aeldar/biggus-darkus/firmware/README.md

# Biggus Darkus — Firmware

Arduino firmware for the Biggus Darkus project.

- Sketch: [`BiggusDarkus/BiggusDarkus.ino`](BiggusDarkus/BiggusDarkus.ino) — open this folder in the Arduino IDE.
- Wiring: [`docs/hardware.md`](docs/hardware.md) — pin numbers live in [`BiggusDarkus/pins.h`](BiggusDarkus/pins.h).
- Architecture: [`docs/architecture.md`](docs/architecture.md) — modes and module layout.
- Serial commands: [`docs/commands.md`](docs/commands.md) — console protocol and command reference.

## License

MIT — see [LICENSE](LICENSE).
