aeldar/biggus-darkus/pcb/biggus-darkus-pcb.kicad_pcb

## KiCad design pcb/biggus-darkus-pcb.kicad_pcb (2026-11-14)

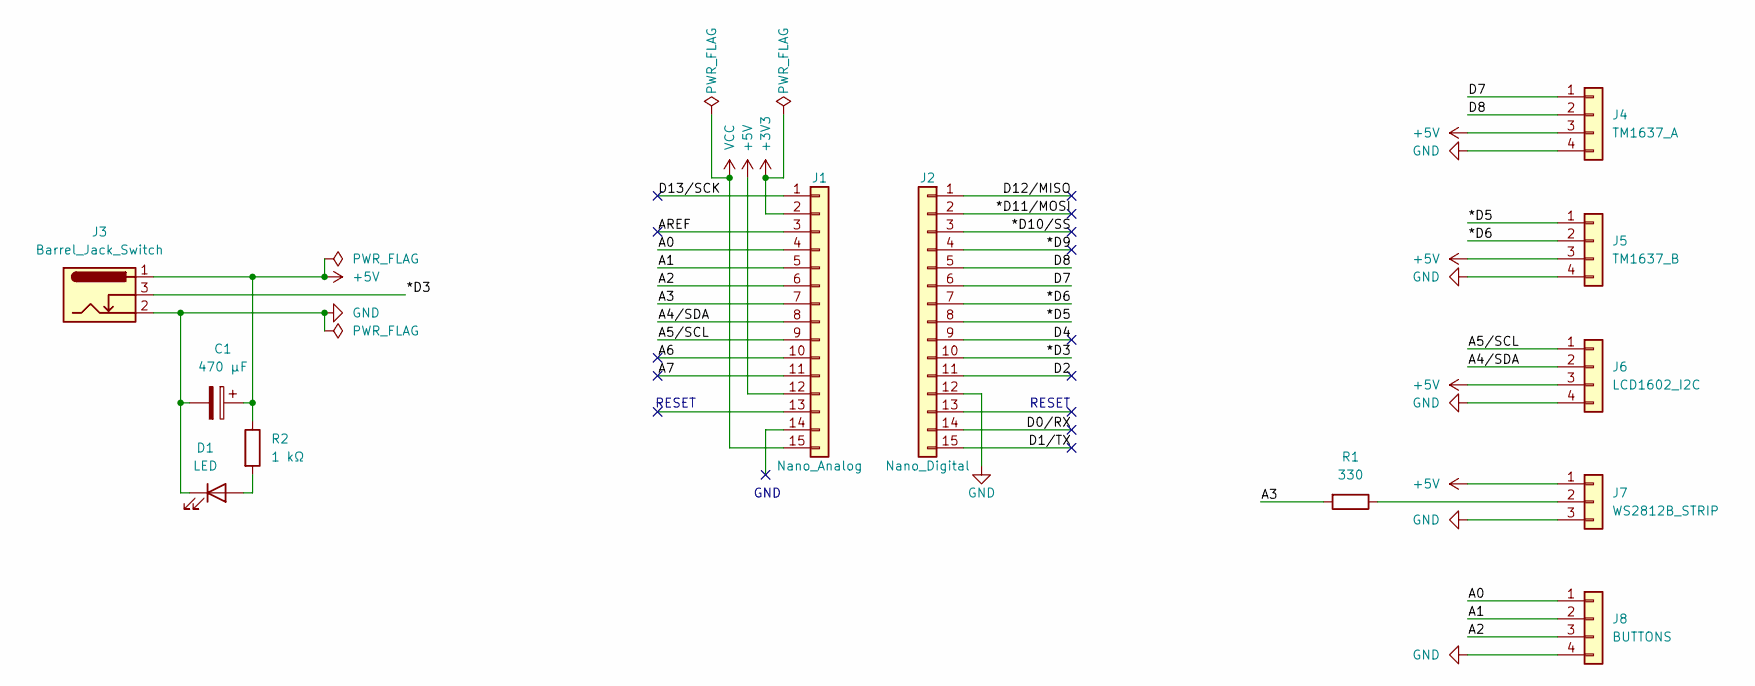
[picture p1: schematic biggus-darkus-pcb.kicad_sch, Biggus Darkus]

Parts:
C1: 470 µF; CP_Radial_D6.3mm_P2.50mm
D1: LED; LED_D5.0mm
J1: Nano_Analog; PinSocket_1x15_P2.54mm_Vertical
J2: Nano_Digital; PinSocket_1x15_P2.54mm_Vertical
J3: Barrel_Jack_Switch; BarrelJack_Horizontal
J4: TM1637_A; JST_XH_S4B-XH-A_1x04_P2.50mm_Horizontal
J5: TM1637_B; JST_XH_S4B-XH-A_1x04_P2.50mm_Horizontal
J6: LCD1602_I2C; JST_XH_S4B-XH-A_1x04_P2.50mm_Horizontal
J7: WS2812B_STRIP; JST_XH_S3B-XH-A_1x03_P2.50mm_Horizontal
J8: BUTTONS; JST_XH_S4B-XH-A_1x04_P2.50mm_Horizontal
R1: 330; R_Axial_DIN0207_L6.3mm_D2.5mm_P10.16mm_Horizontal
R2: 1 kΩ; R_Axial_DIN0207_L6.3mm_D2.5mm_P10.16mm_Horizontal

Connections:
+3V3: J1.2
+5V: C1.1, J1.12, J3.1, J4.3, J5.3, J6.3, J7.1, R2.1
/*D3: J2.10, J3.3
/*D5: J2.8, J5.1
/*D6: J2.7, J5.2
/*D9: J2.4
/*D10/SS: J2.3
/*D11/MOSI: J2.2
/A0: J1.4, J8.1
/A1: J1.5, J8.2
/A2: J1.6, J8.3
/A3: J1.7, R1.2
/A4/SDA: J1.8, J6.2
/A5/SCL: J1.9, J6.1
/A6: J1.10
/A7: J1.11
/AREF: J1.3
/D0/RX: J2.14
/D1/TX: J2.15
/D2: J2.11
/D4: J2.9
/D7: J2.6, J4.1
/D8: J2.5, J4.2
/D12/MISO: J2.1
/D13/SCK: J1.1
GND: C1.2, D1.1 (K), J2.12, J3.2, J4.4, J5.4, J6.4, J7.3, J8.4
unnamed: D1.2 (A), R2.2
unnamed: J7.2, R1.1
VCC: J1.15

Notes on the sheet:
GND
RESET

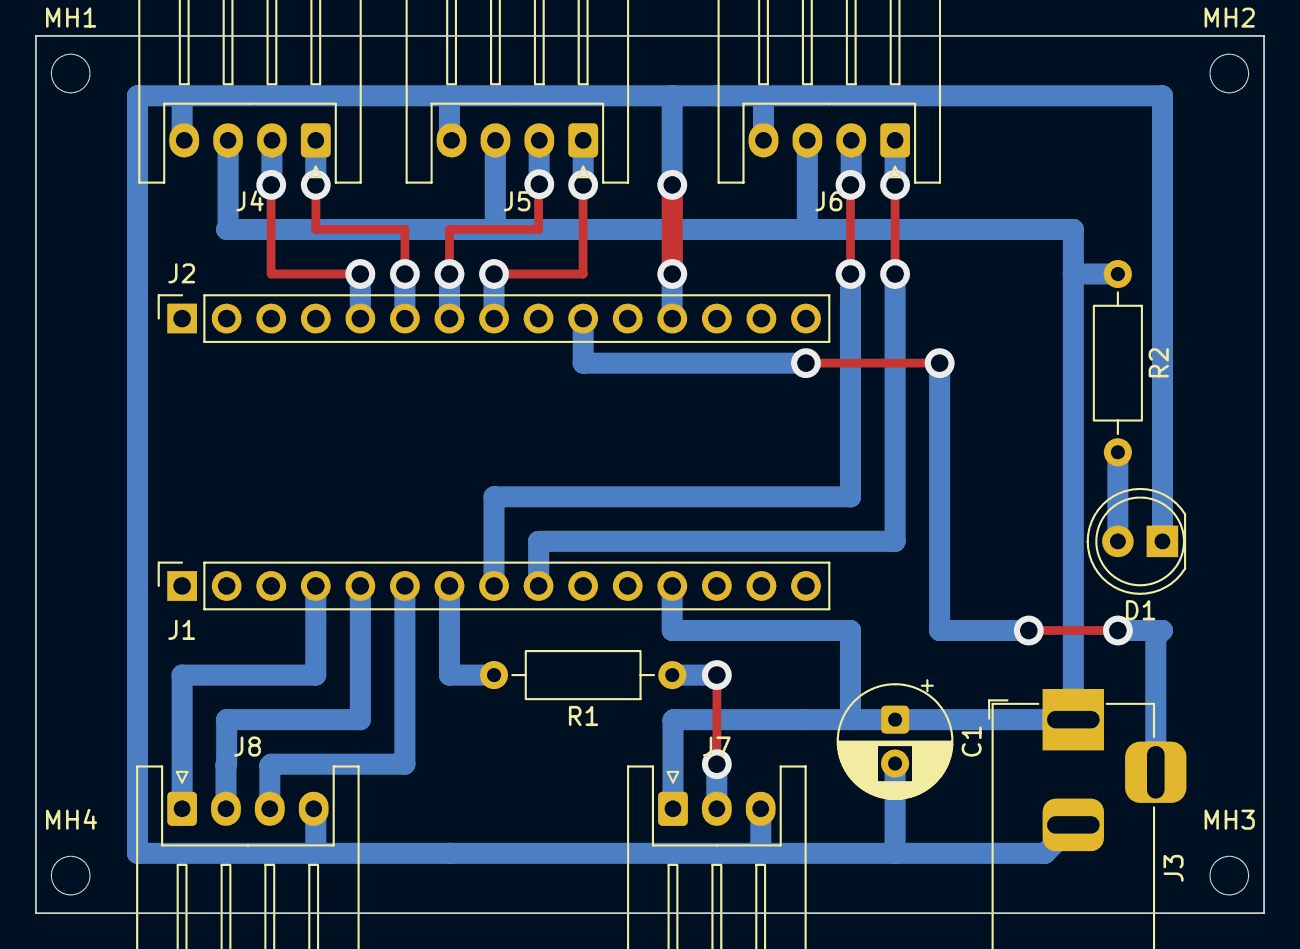
[picture p2: board biggus-darkus-pcb.kicad_pcb from above]

Board: 2 copper layers, 70.0 x 50.0 mm, 16 parts (0 on the bottom side), 15 nets.

Other parts of the board:
MH1, MH2, MH3, MH4: MountingHole_2.2mm_M2
