aeldar/biggus-darkus/(commit log)

2026-10-03 Add .gitignore for Arduino/C++ build artifacts
2026-10-20 add digit displays and lcd i2c
2026-10-20 Fix slow LED animation caused by blocking delay in digit display loop
    loopDigitDisplay() called delay(100) every iteration of the main loop,
    throttling the whole sketch (including FastLED) to ~10fps. Use millis()
    based timing instead so the digit display update doesn't block FastLED.
    [DemoReel100.ino]
2026-10-28 change pins, add current optimizations
2026-10-28 Add A0 button to toggle demo mode on and off
    When off, the LCD shows "Demo OFF" and the LED strip and TM1637 displays are blanked.
2026-10-28 Show FPS and estimated LED current on LCD row 2
2026-10-28 Move pin wiring into pins.h
2026-10-28 Document hardware wiring and pin map
2026-10-28 Note Arduino Nano as the target board
2026-10-28 Cap strip at 400 mA and mark over-cap readings on the LCD
2026-10-28 Document power supply as interchangeable
2026-10-29 Pin Nano FQBN for arduino-cli
2026-10-29 Move LCD status and button debounce into modules
2026-10-29 Add global modes and serial control
    Split hardware behaviour into app_mode, serial_commands, four_digit_display, counter_display, led_strip and status_lcd modules. Add MODE DEMO/ACTIVE/OFF, time modes, counter modes, LCD text and LED overlays. Document the architecture and command protocol.
2026-10-29 Fix clock day length overflow on 16-bit AVR int
    [four_digit_display.cpp]
2026-11-03 Make new LED range replace overlapping overlays
    Older overlays are trimmed, split or removed where the new range
    overlaps them, so stale animations no longer show through.
    [led_strip.cpp]
2026-11-03 Store LED command state per LED instead of overlay slots
    Each LED remembers its own state, so a new range overwrites old
    animations without slot limits. Adds manual overlap tests.
2026-11-07 Milestone 1: bd-protocol typed device language and generated docs
2026-11-07 Milestone 2: bd-device serial link, fake board and bd-cli send
2026-11-07 Milestone 4a: bd-rules config, priority resolver and default rules
    [config.rs, lib.rs, plan.rs, template.rs]
2026-11-07 Milestone 4b: bd-cli run joins journal, rules and device
2026-11-07 Retry MODE ACTIVE while the board boots; report why connecting failed
2026-11-07 Add pcb (KiCad design)
    [biggus-darkus-pcb.kicad_pcb, biggus-darkus-pcb.kicad_sch]
2026-11-07 Ignore KiCad per-user view state
2026-11-10 add kicad skills
2026-11-10 improve schematics
    [biggus-darkus-pcb.kicad_pcb, biggus-darkus-pcb.kicad_sch]
2026-11-10 tune the board
    [biggus-darkus-pcb.kicad_pcb]
2026-11-11 clean up schematics
    [biggus-darkus-pcb.kicad_sch]
2026-11-11 correct the schematics
    [biggus-darkus-pcb.kicad_sch]
2026-11-11 correct power pins on a barrel
    [biggus-darkus-pcb.kicad_sch]
2026-11-11 improve power
    [biggus-darkus-pcb.kicad_sch]
2026-11-11 initial design of pcb
    [biggus-darkus-pcb.kicad_pcb]
2026-11-11 add buttons to schematics
    [biggus-darkus-pcb.kicad_sch]
2026-11-11 add buttons to pcb
    [biggus-darkus-pcb.kicad_pcb]
2026-11-11 mirror pins in connectors
    [biggus-darkus-pcb.kicad_pcb, biggus-darkus-pcb.kicad_sch]
2026-11-11 add no-connection to schematics pins
    [biggus-darkus-pcb.kicad_sch]
2026-11-11 update nano pins
    [biggus-darkus-pcb.kicad_pcb, biggus-darkus-pcb.kicad_sch]
2026-11-11 use pin socket for nano, instead of pinheader
    [biggus-darkus-pcb.kicad_pcb, biggus-darkus-pcb.kicad_sch]
2026-11-11 use pin socket footprint for nano in pcb
    [biggus-darkus-pcb.kicad_pcb]
2026-11-11 update pcb;
    [biggus-darkus-pcb.kicad_pcb]
2026-11-11 align the grid
    [biggus-darkus-pcb.kicad_pcb]
2026-11-11 fix barrel postion
    [biggus-darkus-pcb.kicad_pcb]
2026-11-11 remove holes
2026-11-11 fit into a perfboard sized 23x18
    [biggus-darkus-pcb.kicad_pcb]
2026-11-13 pcb: align holes and pins according to the real perfboard
    [biggus-darkus-pcb.kicad_pcb]
2026-11-13 correct positions of components a little
    [biggus-darkus-pcb.kicad_pcb]
2026-11-13 add rails. Move led strip D4 -> A3
    [biggus-darkus-pcb.kicad_pcb, biggus-darkus-pcb.kicad_sch]
2026-11-13 add most of the baskside tracks
    [biggus-darkus-pcb.kicad_pcb]
2026-11-13 add forground connectors, fix back ones
    [biggus-darkus-pcb.kicad_pcb]
2026-11-13 fix errors in pcb
    [biggus-darkus-pcb.kicad_pcb, biggus-darkus-pcb.kicad_sch]
2026-11-13 pcb: finalize the design
    [biggus-darkus-pcb.kicad_pcb, biggus-darkus-pcb.kicad_sch]
2026-11-13 add wiring docs
2026-11-13 firmware: move led strip pin D4 -> A3
2026-11-13 add buttons connector to the left
    [biggus-darkus-pcb.kicad_pcb]
2026-11-13 clean up;
    [biggus-darkus-pcb.kicad_pcb]
2026-11-13 update wiring docs
2026-11-13 optimize led strip power
    [biggus-darkus-pcb.kicad_pcb]
2026-11-13 optimize led strip connector
    [biggus-darkus-pcb.kicad_pcb]
2026-11-14 mvoe power led up, fix some wiring
    [biggus-darkus-pcb.kicad_pcb]
2026-11-14 add comments
    [biggus-darkus-pcb.kicad_pcb]
2026-11-14 tune the wires
    [biggus-darkus-pcb.kicad_pcb]
